WasabiMushyPeas/OPTICAL-FLOW-SENSOR/SLIDE-IMAGES/ofs-board-top.png

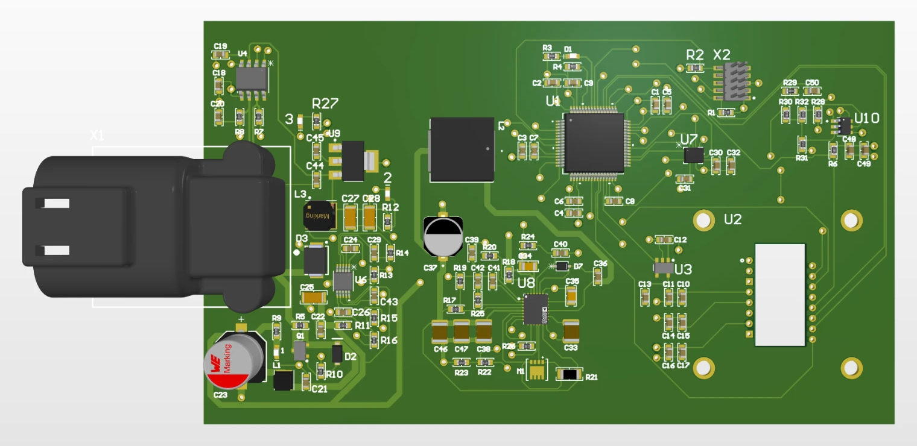
SLIDE-IMAGES/ofs-board-top.png
