WasabiMushyPeas/OPTICAL-FLOW-SENSOR/CAD/04_nine_led_layout_dimensioned.png

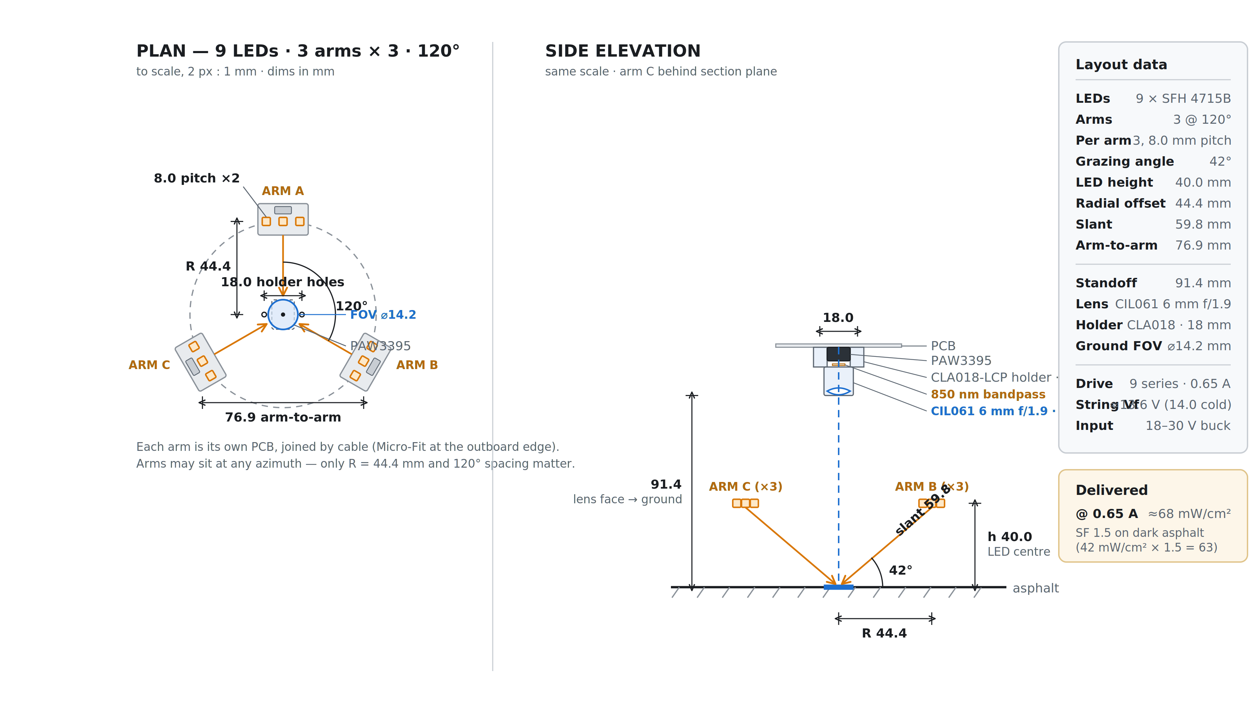
CAD/04_nine_led_layout_dimensioned.png
