WasabiMushyPeas/OPTICAL-FLOW-SENSOR/OFS.drawio.png

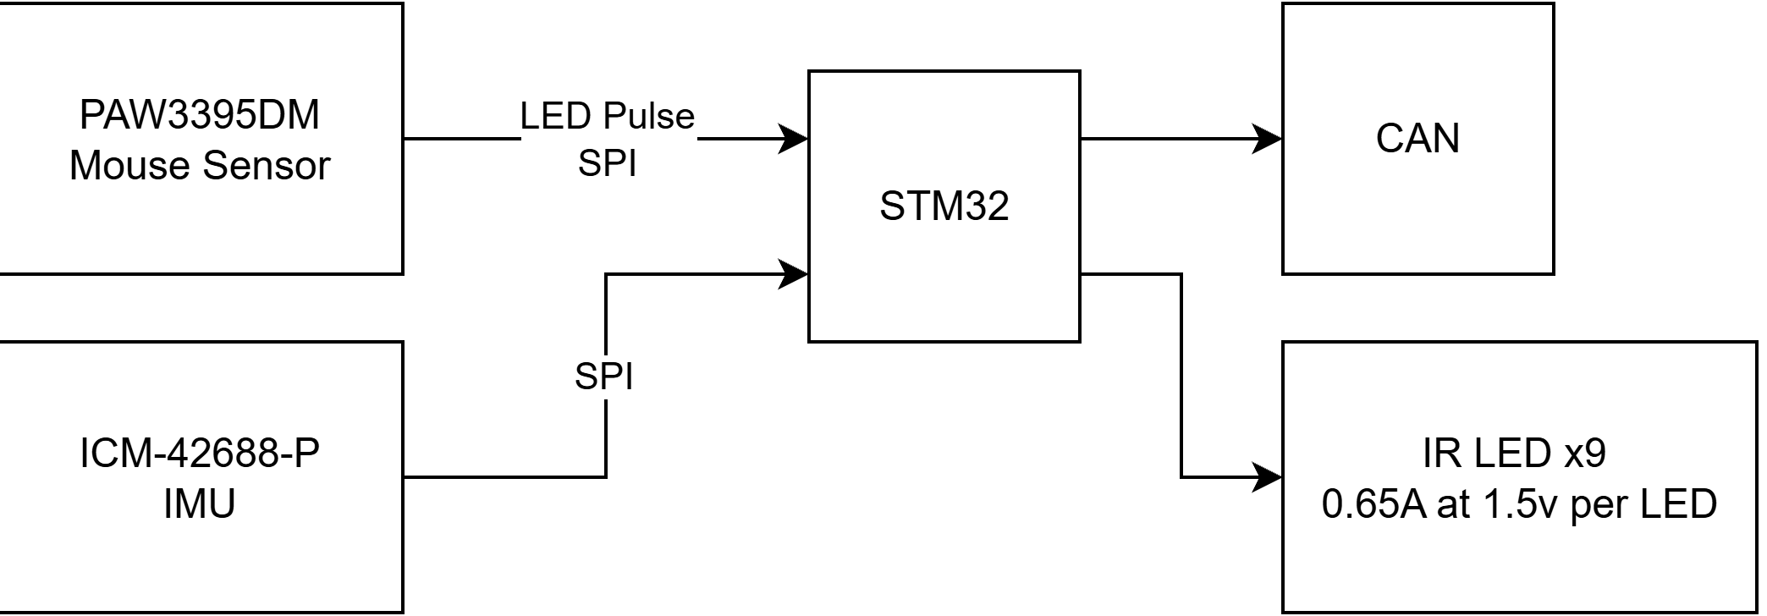
OFS.drawio.png
