WasabiMushyPeas/OPTICAL-FLOW-SENSOR/OFS.png

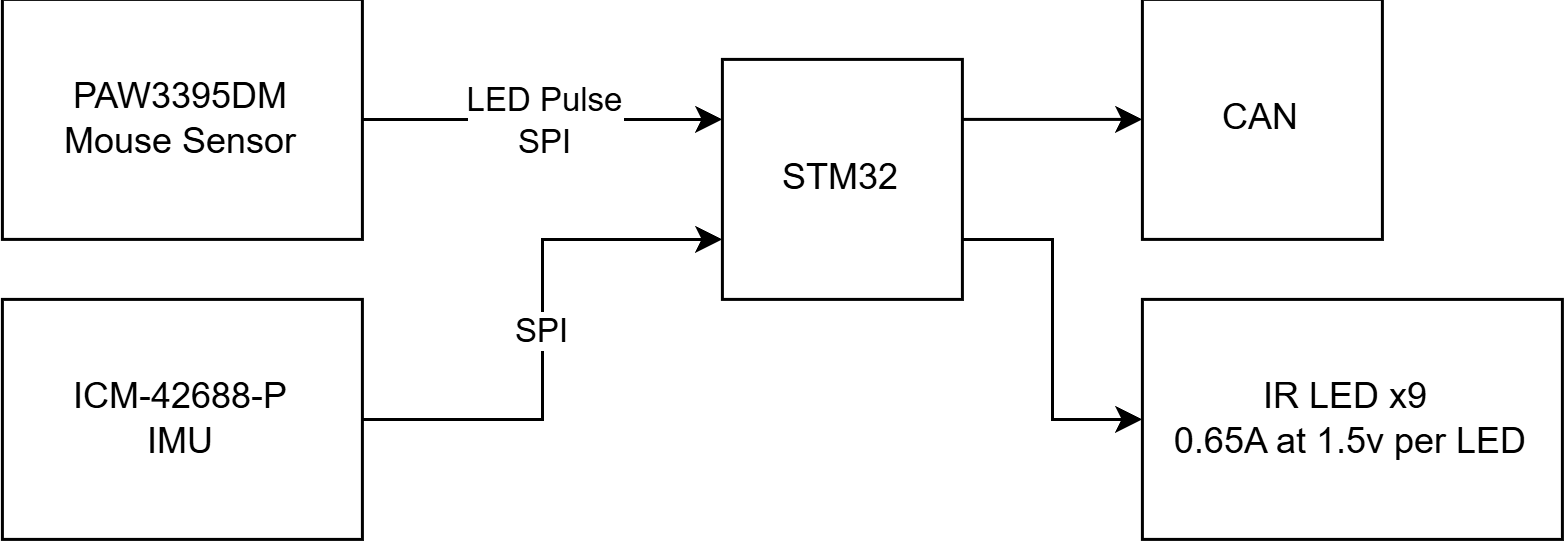
OFS.png
