WasabiMushyPeas/OPTICAL-FLOW-SENSOR/SLIDE-IMAGES/ofs-board-bottom.png

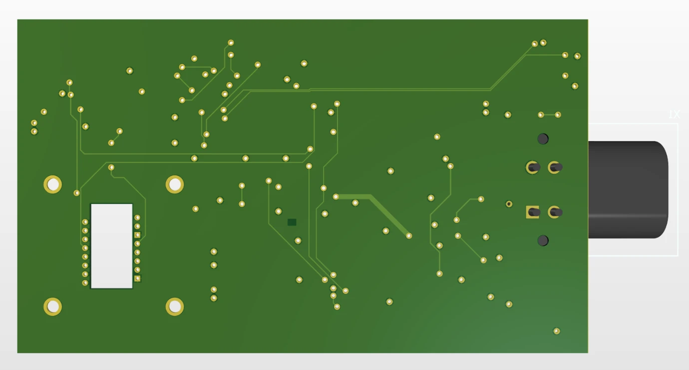
SLIDE-IMAGES/ofs-board-bottom.png
