WasabiMushyPeas/OPTICAL-FLOW-SENSOR/CAD/1-25MM-AP.SLDPRT

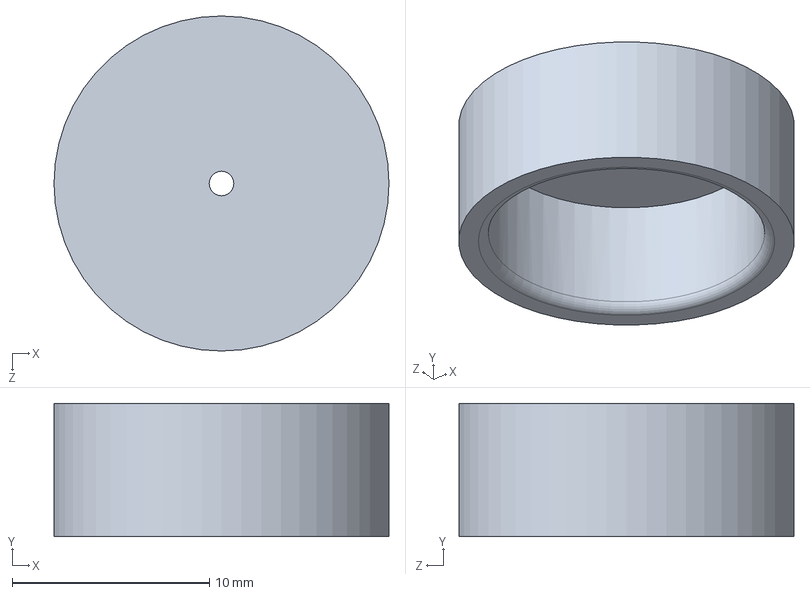
[picture p6: CAD file, 2026-08-03]
CAD/1-25MM-AP.SLDPRT
17.0 x 6.75 x 17.0 mm
