WasabiMushyPeas/OPTICAL-FLOW-SENSOR/CAD/CLA018/CLA018.stp

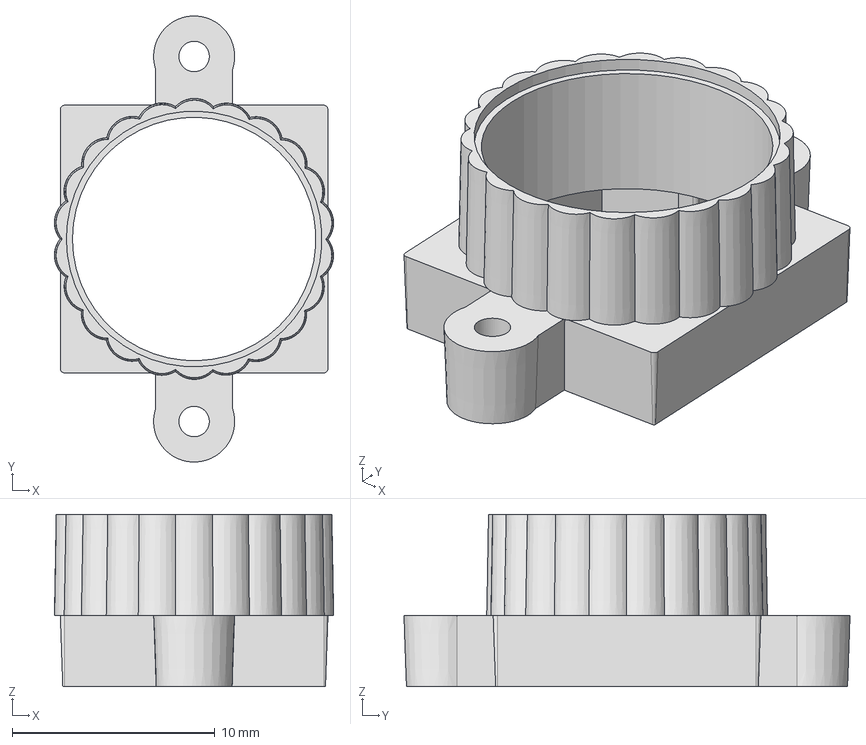
[picture p7: CAD file, 2026-07-28]
CAD/CLA018/CLA018.stp
13.8 x 22.0 x 8.50 mm
