WasabiMushyPeas/OPTICAL-FLOW-SENSOR/CAD/PCBs/OFS-BOARD.SLDPRT

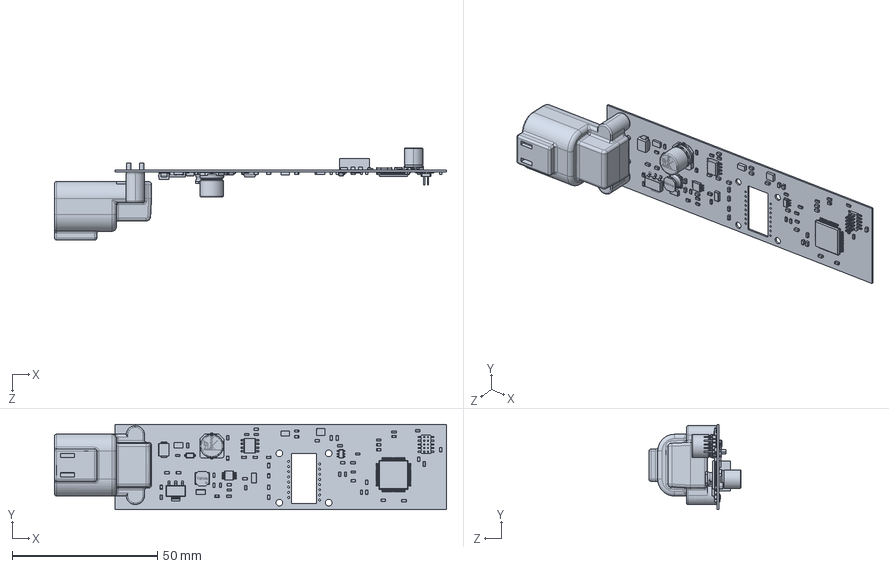
[picture p8: CAD file, 2026-09-30]
CAD/PCBs/OFS-BOARD.SLDPRT
135.1 x 29.4 x 31.9 mm
