WasabiMushyPeas/OPTICAL-FLOW-SENSOR/CAD/LENS-MOUNT.SLDPRT

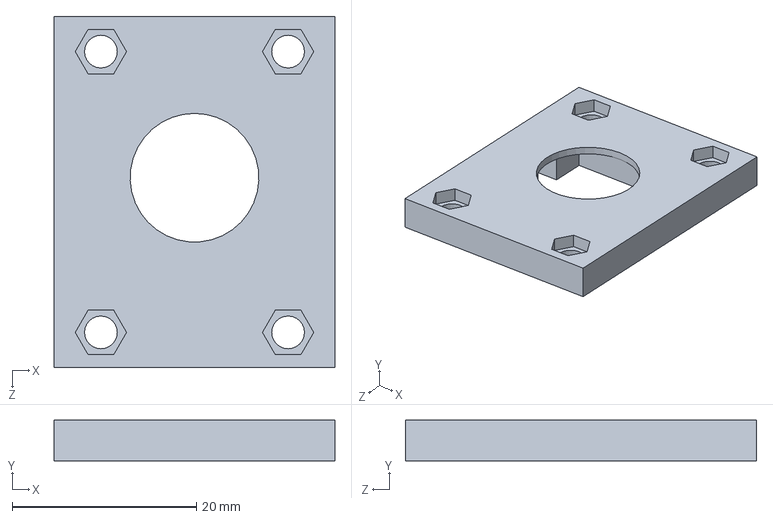
[picture p9: CAD file, 2026-08-03]
CAD/LENS-MOUNT.SLDPRT
30.5 x 4.45 x 38.1 mm
