WasabiMushyPeas/OPTICAL-FLOW-SENSOR/CAD/PCBs/LED-PCB.SLDPRT

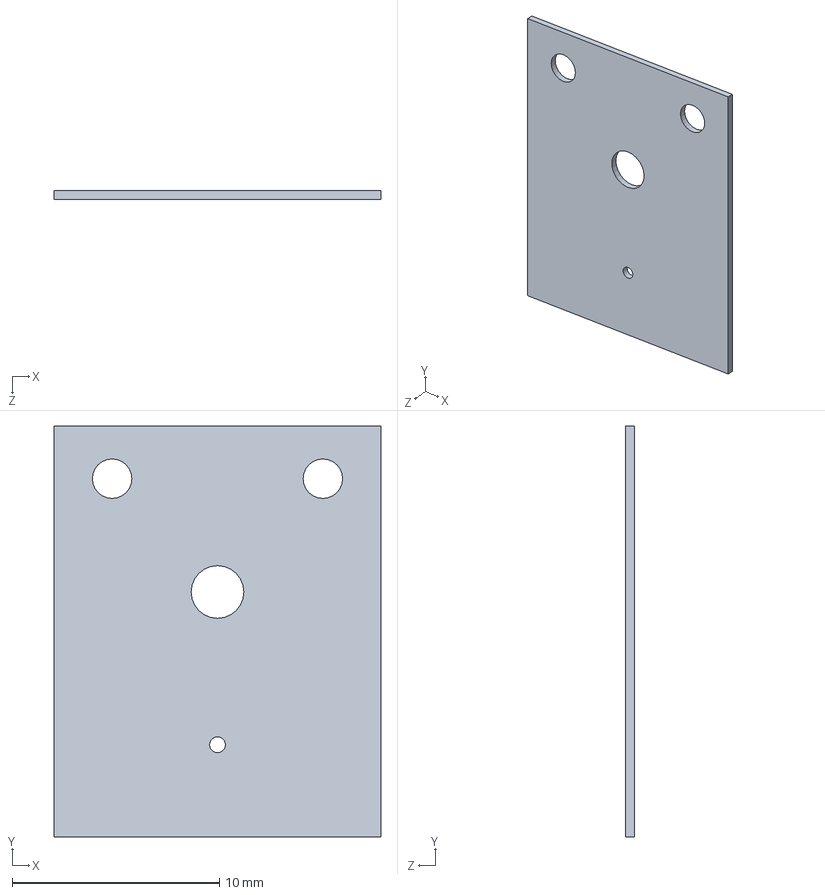
[picture p10: CAD file, 2026-09-09]
CAD/PCBs/LED-PCB.SLDPRT
15.7 x 19.8 x 0.411 mm
