WasabiMushyPeas/OPTICAL-FLOW-SENSOR/CAD/LENS-MOUNT-ALIGN.SLDPRT

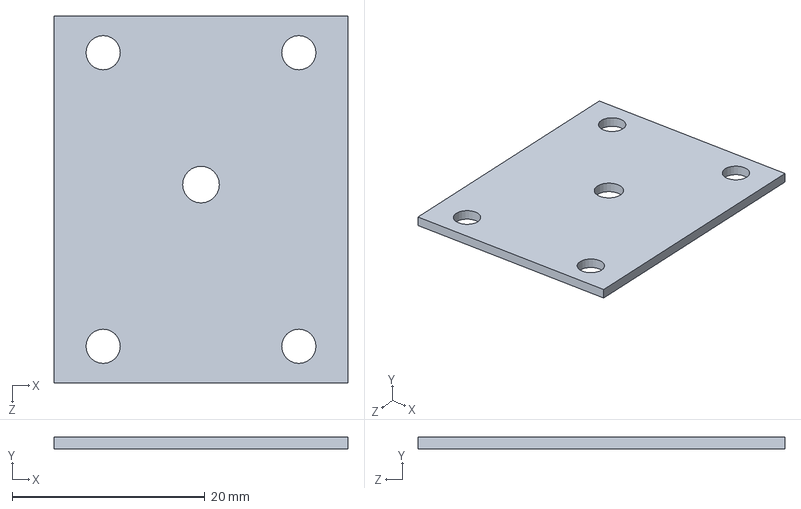
[picture p11: CAD file, 2026-07-28]
CAD/LENS-MOUNT-ALIGN.SLDPRT
30.5 x 1.27 x 38.1 mm
