WasabiMushyPeas/OPTICAL-FLOW-SENSOR/(list of files, cad)

Other CAD files:
CAD/LENS/1-5MM-AP.SLDPRT
CAD/1-25MM-AP.STL
CAD/CLA018/CLA018.SLDASM
CAD/LENS-MOUNT-ALIGN.STL
CAD/LENS-MOUNT.STL
CAD/PCBs/OFS-BOARD.x_t
