WasabiMushyPeas/OPTICAL-FLOW-SENSOR/PCB/OPTICAL-FLOW-PCB-STM32-V2/OPTICAL-FLOW-BOARD.pdf

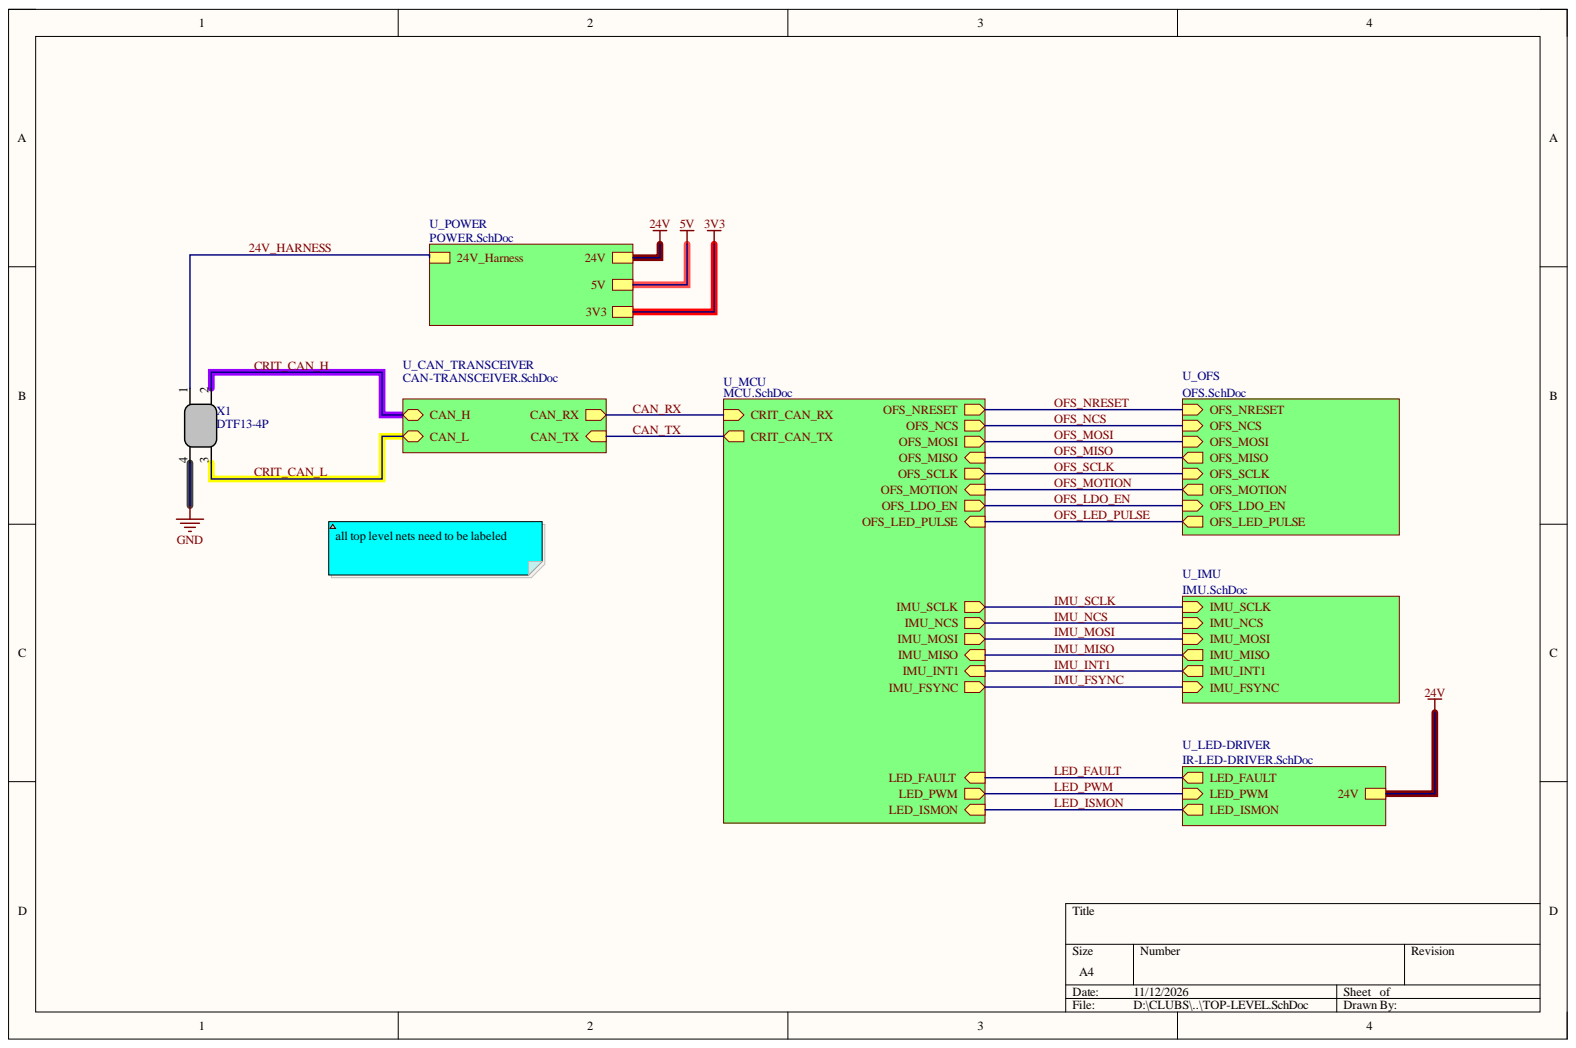
[picture p12: page 1]

all top level nets ne

ed to be labele

Siz e A4 | Numb e r | R evisio n

Da te : 11/12/20 2 6 | She et of
File : D:\CLUB S\. .\TOP -LE V EL . S c hD o c | Dr awn B y :

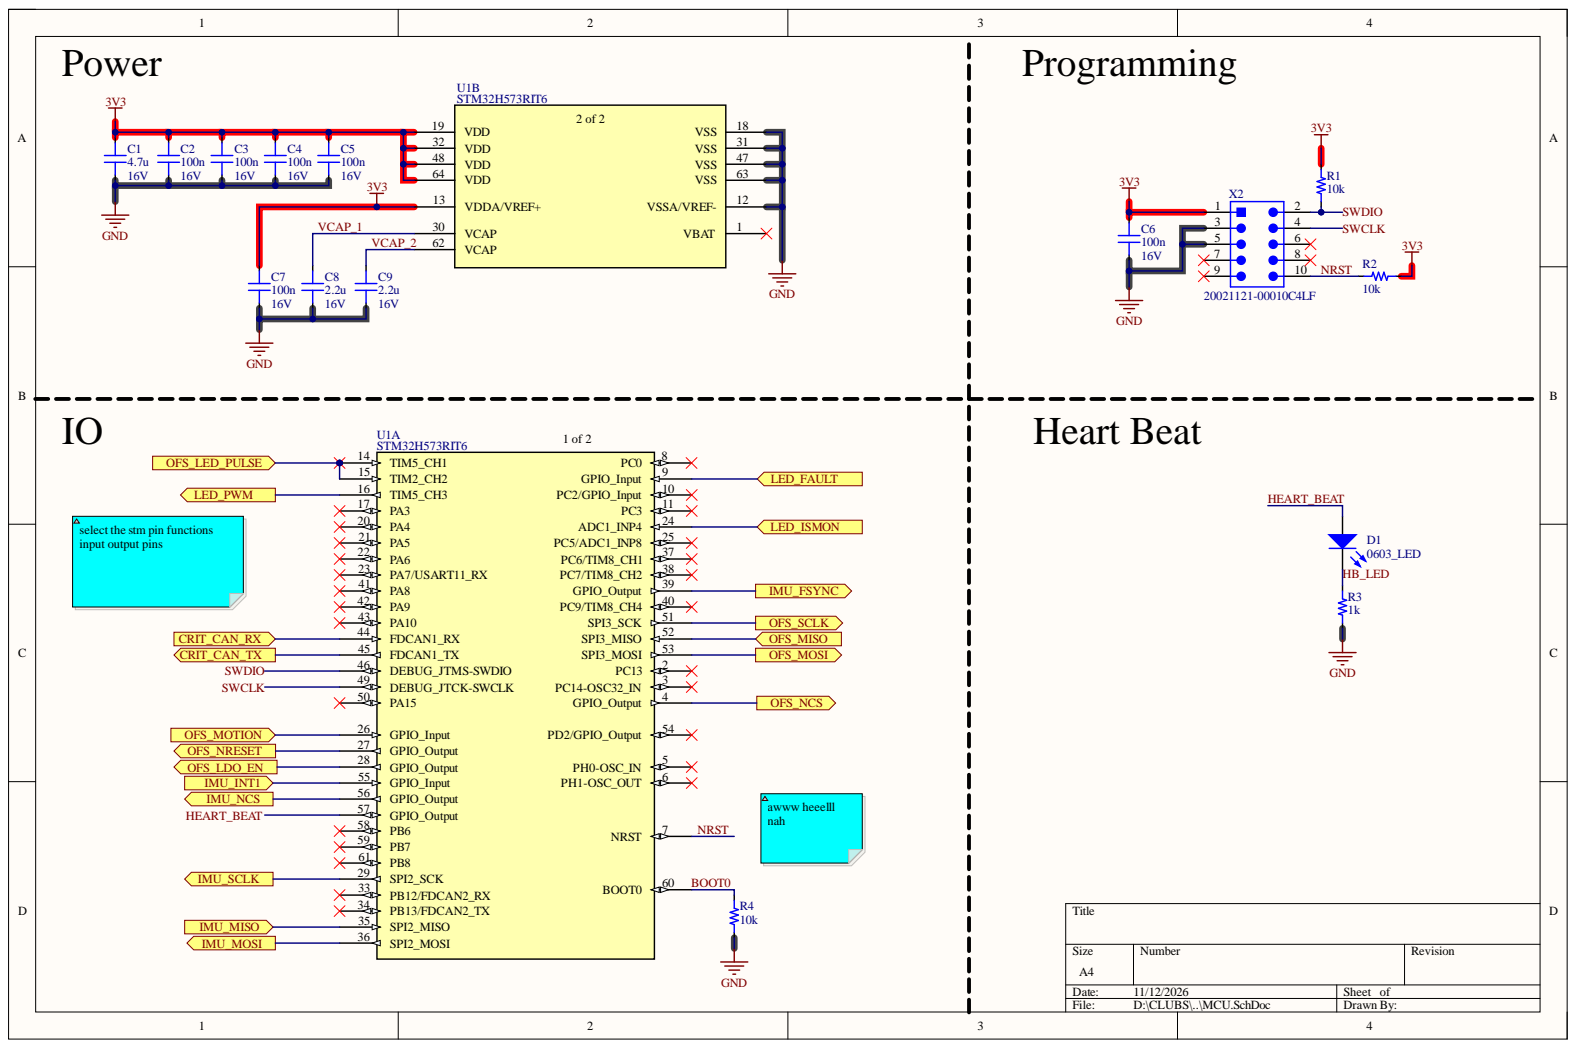
[picture p13: page 2]

VCAP_1 | VCAP 30

VCAP_2 | VCAP 62

select the stm pin functions
input output pins

Size A4 | Number | Revision

Date: 11/12/2026 | Sheet of
File: D:\CLUBS\..\MCU.SchDoc | Drawn By:

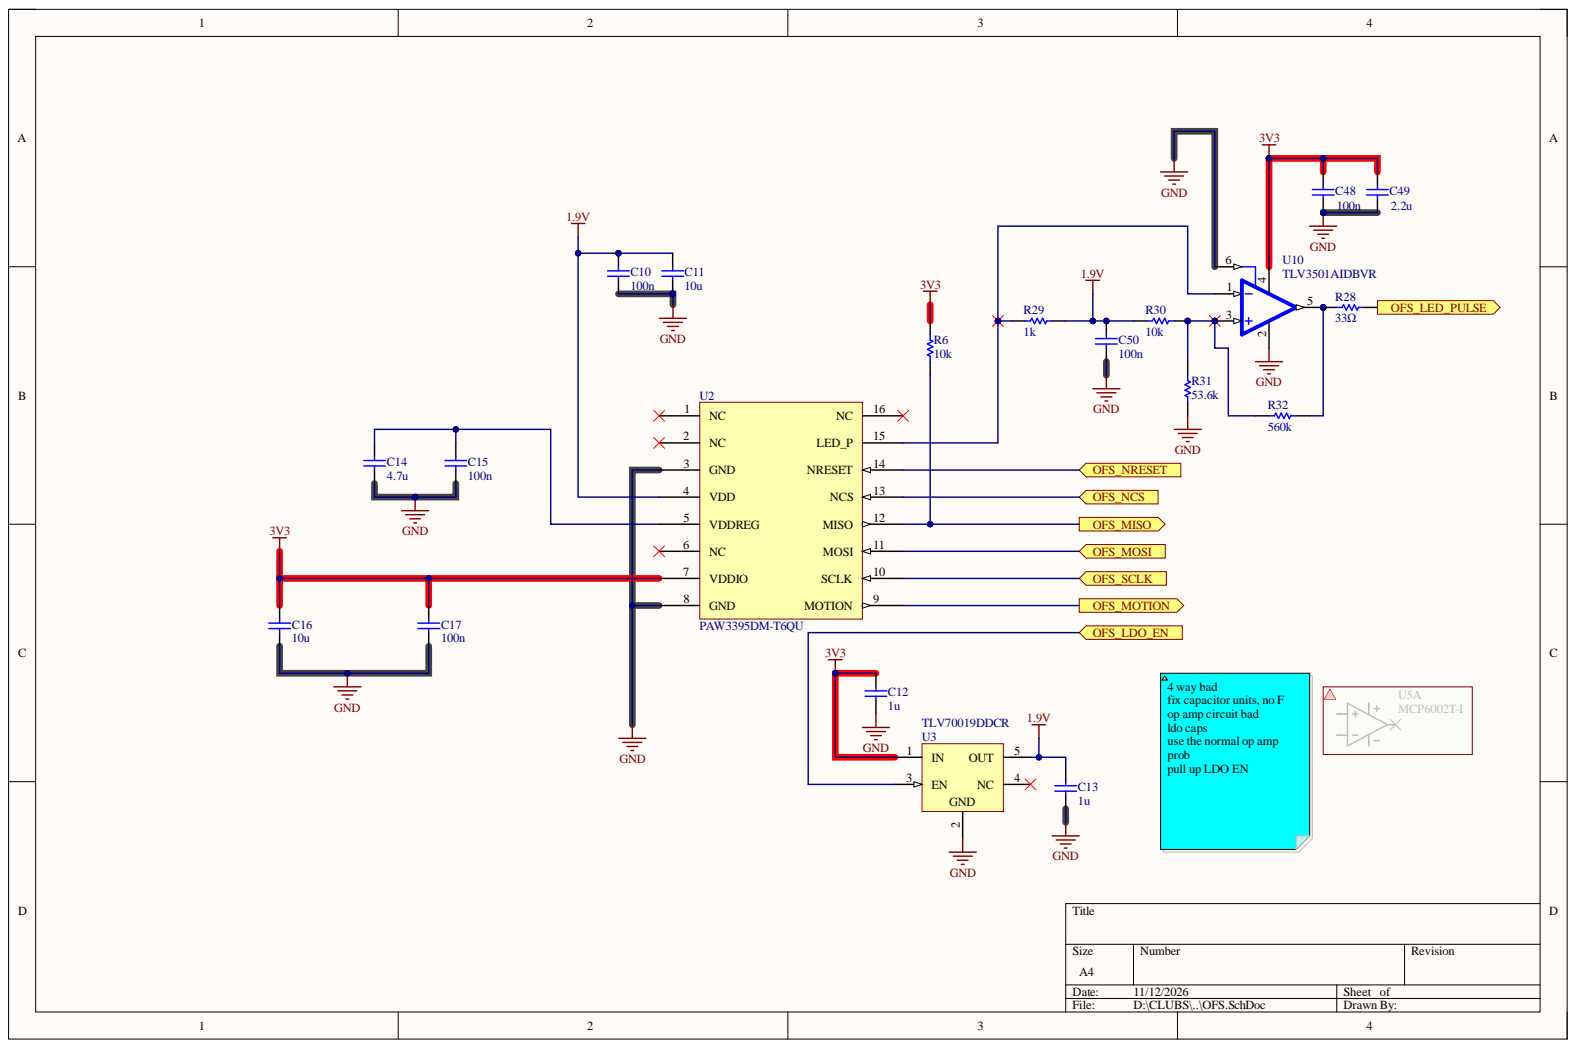
[picture p14: page 3]

4 way ba
fix
ldo
use the normal op
pull up LDO EN

Siz e A4 | Numb e r | R evisio n

Da te : 11/12/20 2 6 | She et of
File : D:\CLUB S\. .\OF S . S c hD o c | Dr awn B y :

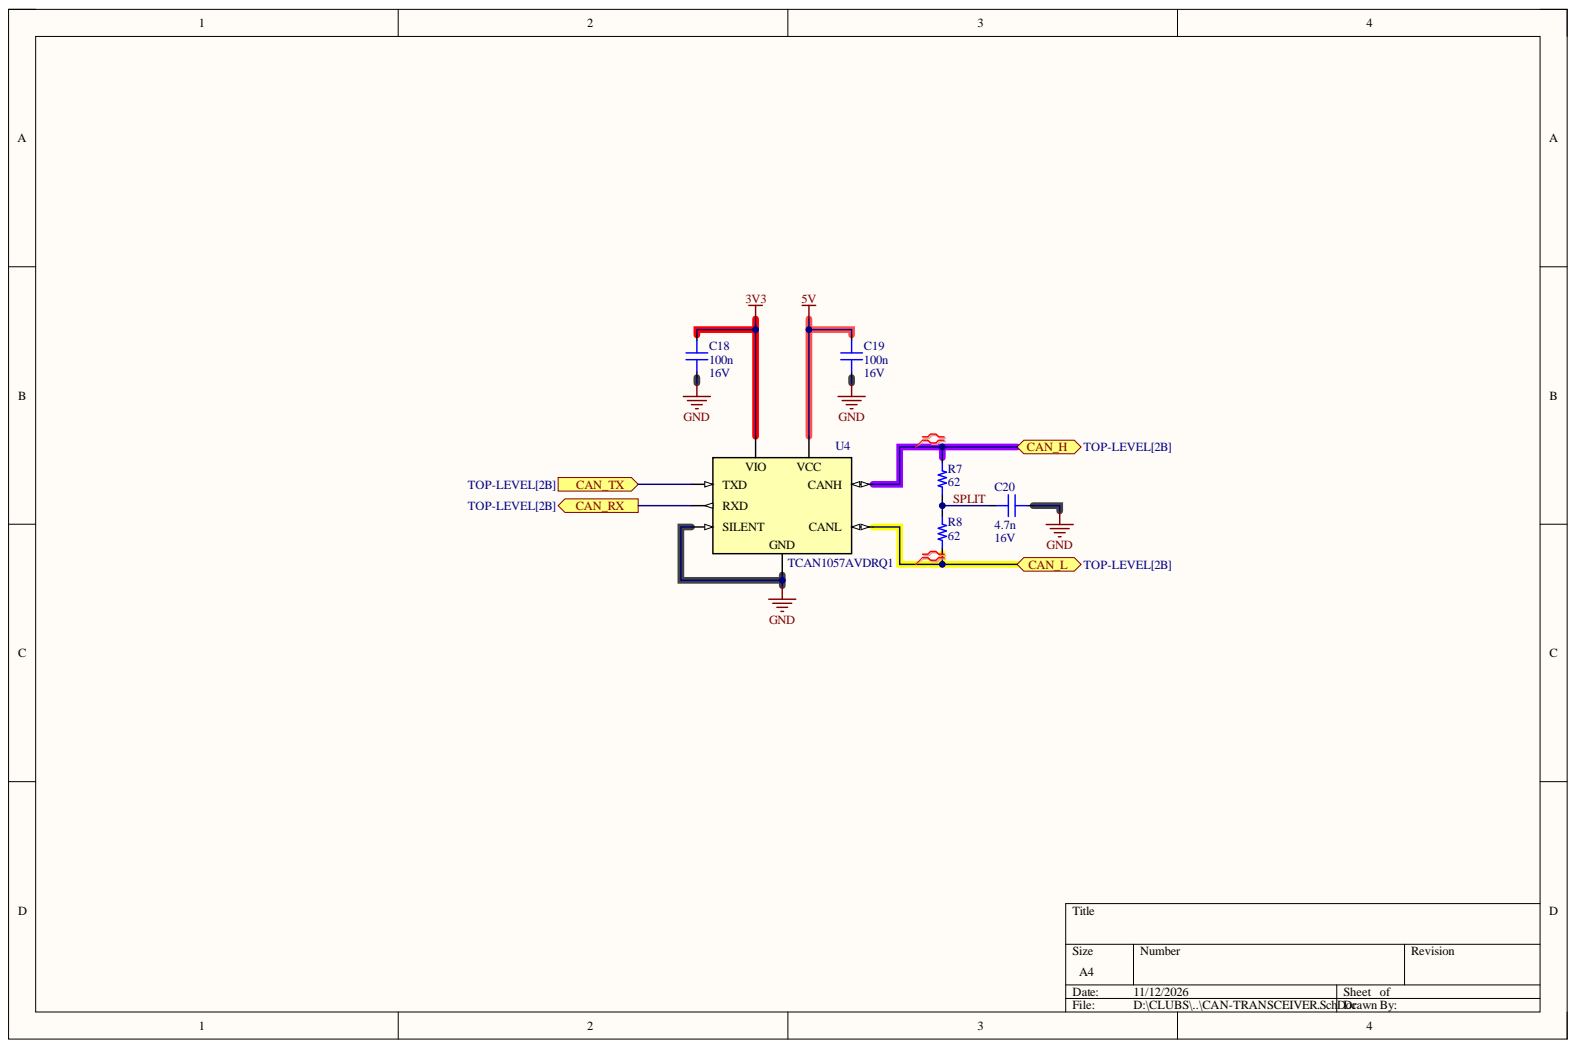
[picture p15: page 4]

Size A4 | Number | Revision

Date: 11/12/2026 | Sheet of
File: D:\CLUBS\..\CAN-TRANSCEIVER.SchDDr ocawn By:

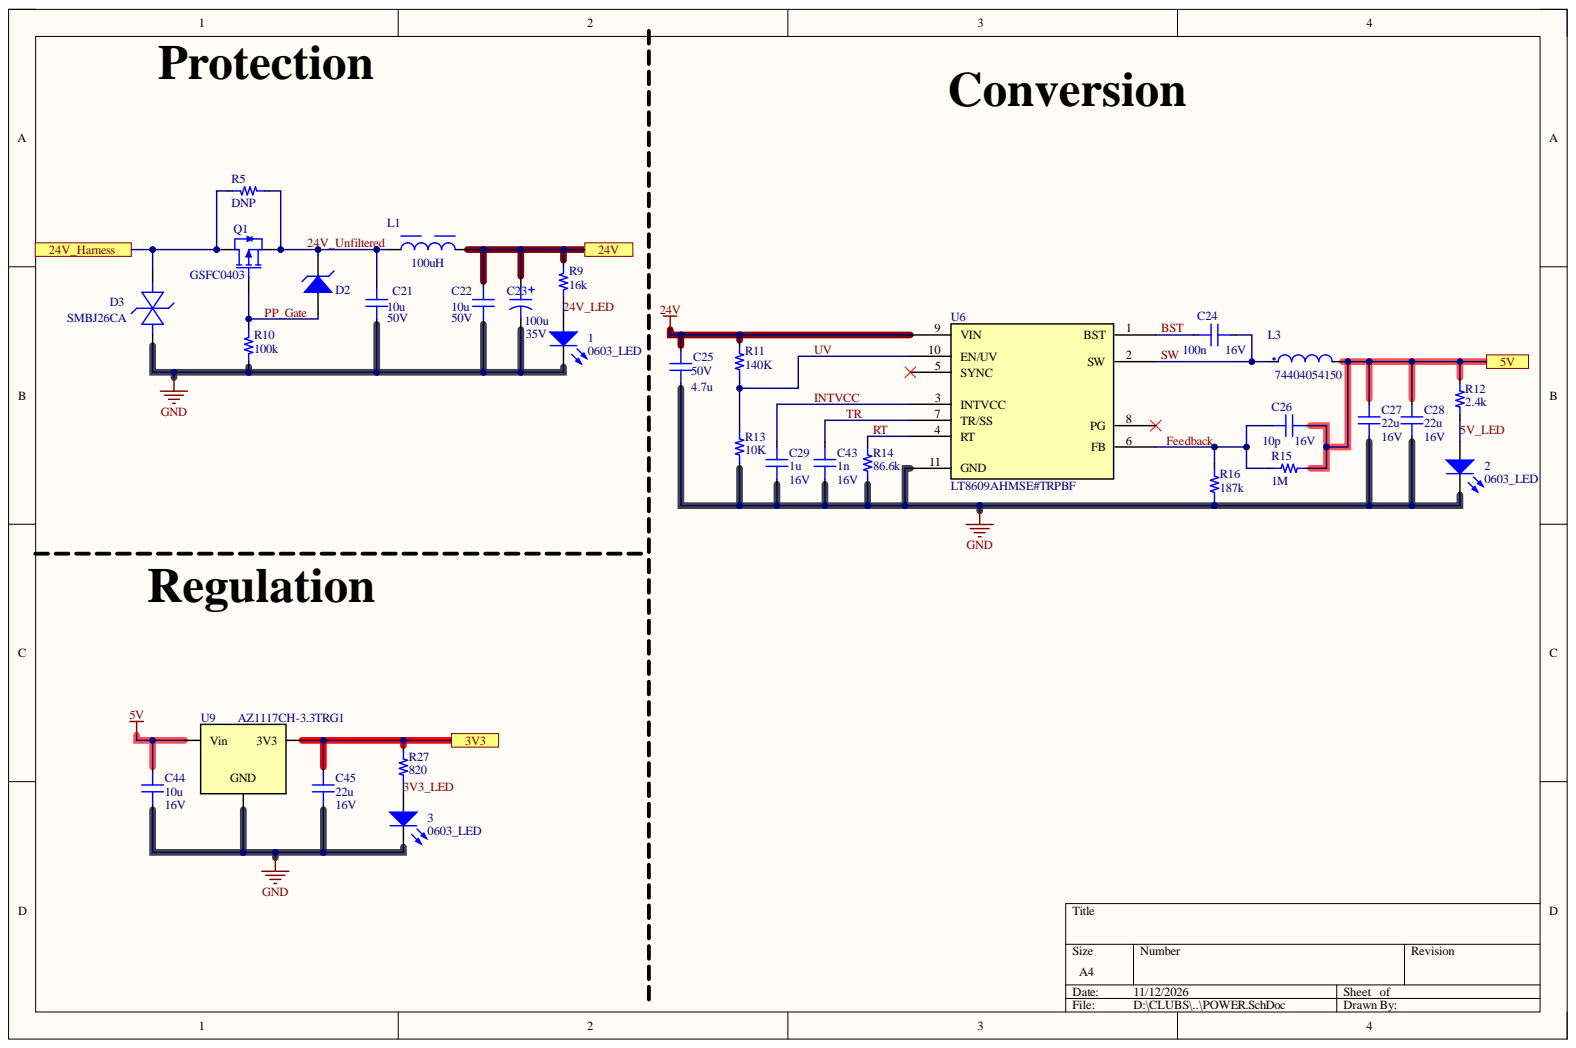
[picture p16: page 5]

Size A4 | Number | Revision

Date: 11/12/2026 | Sheet of
File: D:\CLUBS\..\POWER.SchDoc | Drawn By:

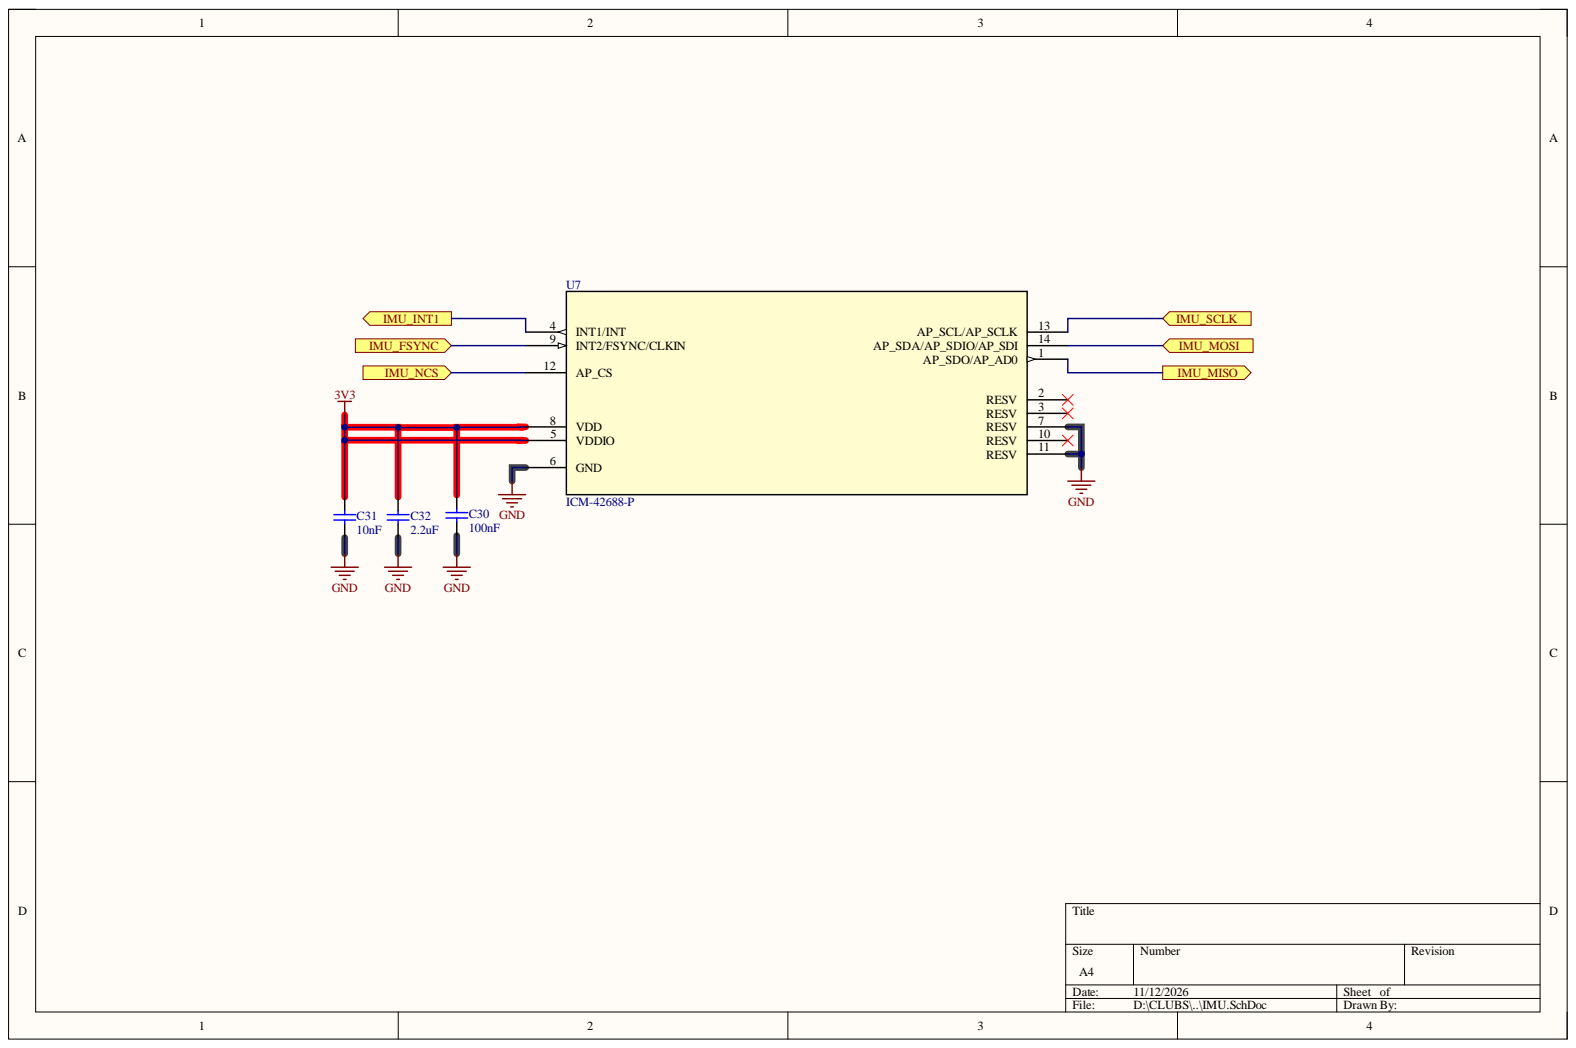
[picture p17: page 6]

Siz e A4 | Numb e r | R evisio n

Da te : 11/12/20 2 6 | She et of
File : D:\CLUB S\. .\IMU. S c hD o c | Dr awn B y :

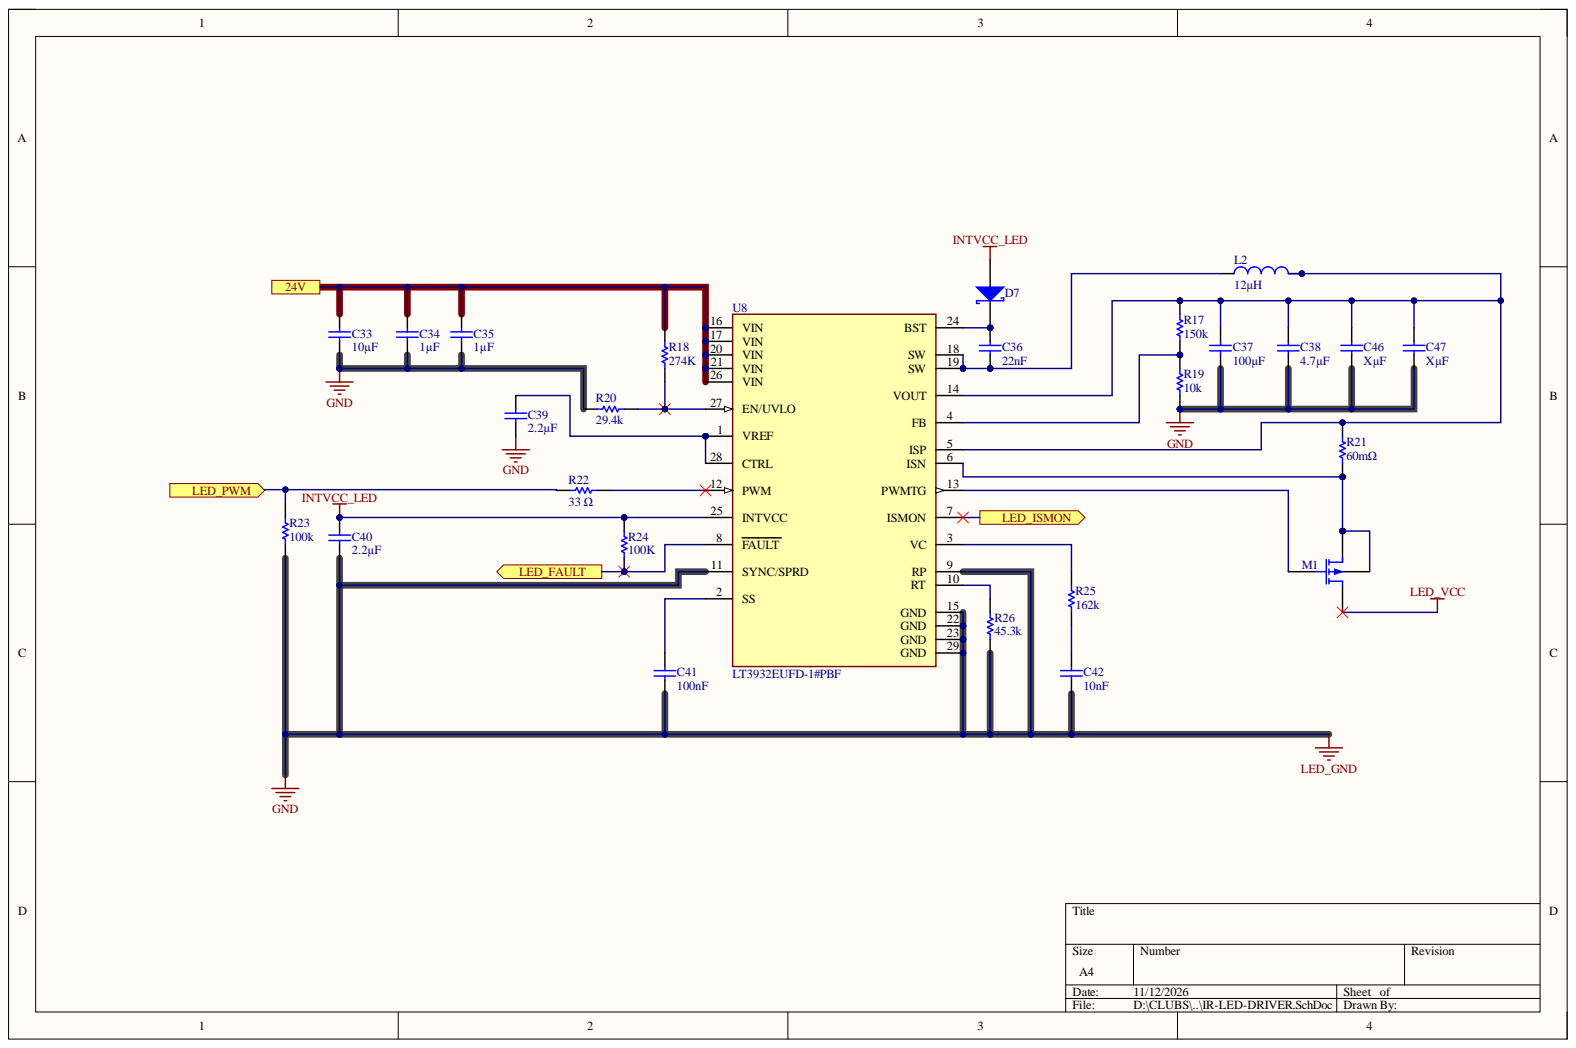
[picture p18: page 7]

Siz e A4 | Numb e r | R evisio n

Da te : 11/12/20 2 6 | She et of
File : D:\CLUB S\. .\I R -LED-DR IVE R . S c hD o c | Dr awn B y :

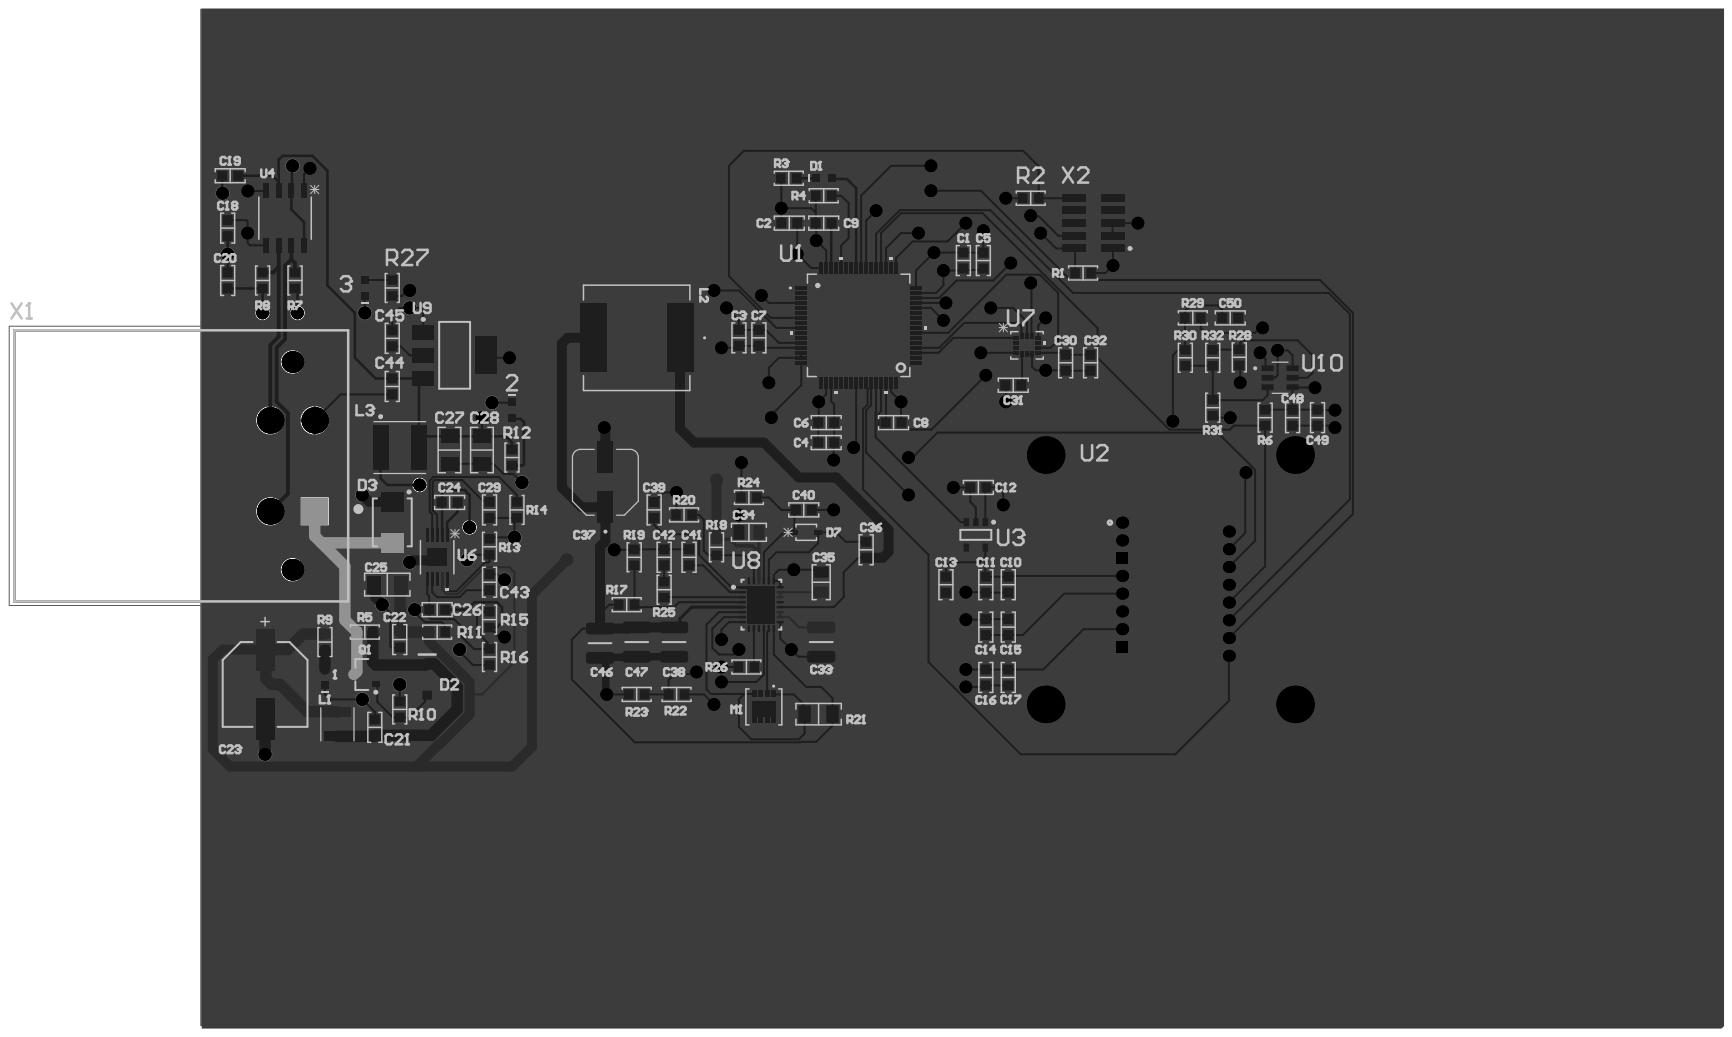
[picture p19: page 8]
