WasabiMushyPeas/OPTICAL-FLOW-SENSOR/CAD/CLA018/CLA018-LCP Lens Holder.pdf

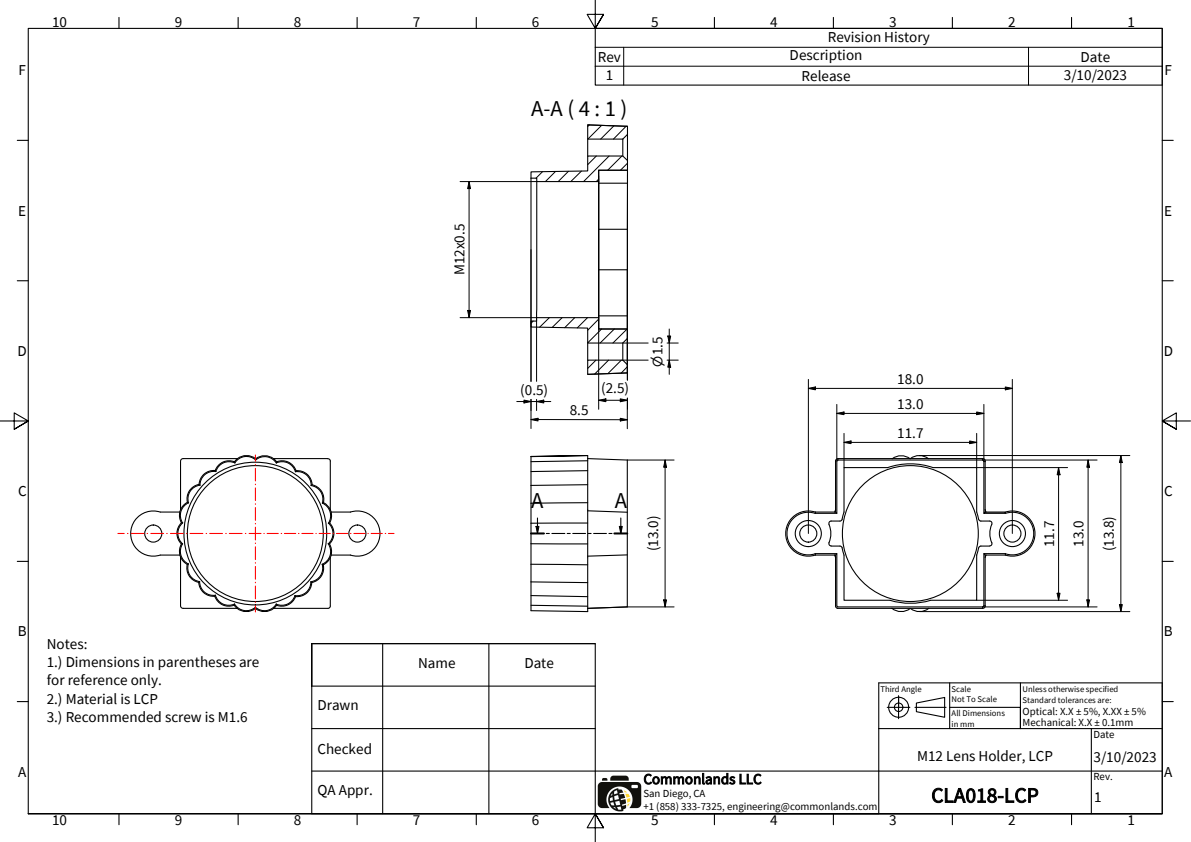
[picture p20: page 1]
M12 Lens Holder, LCP; All Dimensions in mm; QA Appr.

Revision History

Rev | Description | Date
1 | Release | 3/10/2023

Notes:
1.) Dimensions in parentheses are
for reference only.
2.) Material is LCP
3.) Recommended screw is M1.6

Name | Date

Drawn | | | Third Angle | Scale Not To Scale | Unless otherwise specified Standard tolerances are: Optical: X.X ± 5%, X.XX ± 5% Mechanical: X.X ± 0.1mm

Commonlands LLC
San Diego, CA
+1 (858) 333-7325, engineering@commonlands.com
