WasabiMushyPeas/OPTICAL-FLOW-SENSOR/PCB/OPTICAL-FLOW-PCB-STM32-V2/LTSpiceSims/LED-DRIVER.asc

C1: cap; 10µF
C2: cap; 1µF
C3: cap; 1µF
C4: cap; 2.2µF
C5: cap; 2.2µF
C6: cap; 100nF
C7: cap; 10nF
C8: cap; 100µF
C9: cap; 4.7µF
C10: cap; 22nF
D1: diode; SFH4715B
D2: diode; SFH4715B
D3: diode; SFH4715B
D4: diode; SFH4715B
D5: diode; SFH4715B
D6: diode; SFH4715B
D7: diode
L1: ind; 12µH; Rser=1m
M1: pmos; FDS4685
R1: res; 274k
R2: res; 29.4k
R3: res; 33
R4: res; 100k
R5: res; 100k
R6: res; 45.3k
R7: res; 162k
R8: res; 60m
R9: res; 10k
R10: res; 220k
U1: LT3932-1
V1: voltage; 24v
Named nets: 0, LED_PWM, LED_FAULT, INTVcc, LED_ISMON, LED_VCC
.model SFH4715B D(Is=1e-18 N=2.5 Rs=0.25 Cjo=50p Iave=2 Vpk=5 type=LED)
Vp p 0 PULSE(0 3.3 0 10n 10n 3u 1m)
B1 LED_PWM 0 V=if(time<10m, 3.3, V(p))
.tran 0 15m 0 5n startup
