WasabiMushyPeas/OPTICAL-FLOW-SENSOR/(list of files, drawings)

Other design files:
PCB/LED-PCB/CUSTOM-COMPONENTS/OSRAM_SFH4715B_Altium_Library_v3/Imported OSRAM_SFH4715B_Altium_Import_v3.Library.PrjPcb/OSRAM_SFH4715B_Altium_Import_v3.Library.PrjPcb
PCB/LED-PCB/CUSTOM-COMPONENTS/OSRAM_SFH4715B_Altium_Library_v3/Imported OSRAM_SFH4715B_Altium_Import_v3.Library.PrjPcb/OSRAM_SFH4715B_Altium_Import_v3.PCBLIB
PCB/LED-PCB/CUSTOM-COMPONENTS/OSRAM_SFH4715B_Altium_Library_v3/Imported OSRAM_SFH4715B_Altium_Import_v3.Library.PrjPcb/OSRAM_SFH4715B_Altium_Import_v3.SCHLIB
PCB/LED-PCB/LED-PCB.PcbDoc
PCB/LED-PCB/LED-PCB.PrjPcb
PCB/LED-PCB/LED-PCB.SchDoc
PCB/OPTICAL-FLOW-PCB-STM32-V2/CAN-TRANSCEIVER.SchDoc
PCB/OPTICAL-FLOW-PCB-STM32-V2/IMU.SchDoc
PCB/OPTICAL-FLOW-PCB-STM32-V2/IR-LED-DRIVER.SchDoc
PCB/OPTICAL-FLOW-PCB-STM32-V2/MCU.SchDoc
PCB/OPTICAL-FLOW-PCB-STM32-V2/OFS-BOARD.PcbDoc
PCB/OPTICAL-FLOW-PCB-STM32-V2/OFS.SchDoc
PCB/OPTICAL-FLOW-PCB-STM32-V2/OPTICAL-FLOW-BOARD.PrjPcb
PCB/OPTICAL-FLOW-PCB-STM32-V2/POWER.SchDoc
PCB/OPTICAL-FLOW-PCB-STM32-V2/TOP-LEVEL.SchDoc
PCB/OPTICAL-FLOW-PCB-STM32/OPTICAL-FLOW-STM32/CAN_TRANSCEIVER.SchDoc
PCB/OPTICAL-FLOW-PCB-STM32/OPTICAL-FLOW-STM32/CONNECTOR.SchDoc
PCB/OPTICAL-FLOW-PCB-STM32/OPTICAL-FLOW-STM32/IMU.SchDoc
PCB/OPTICAL-FLOW-PCB-STM32/OPTICAL-FLOW-STM32/LED-DRIVER.SchDoc
PCB/OPTICAL-FLOW-PCB-STM32/OPTICAL-FLOW-STM32/MCU.SchDoc
PCB/OPTICAL-FLOW-PCB-STM32/OPTICAL-FLOW-STM32/OFS.SchDoc
PCB/OPTICAL-FLOW-PCB-STM32/OPTICAL-FLOW-STM32/OFS_2027.PcbDoc
PCB/OPTICAL-FLOW-PCB-STM32/OPTICAL-FLOW-STM32/OPTICAL-FLOW-STM32.PrjPcb
PCB/OPTICAL-FLOW-PCB-STM32/OPTICAL-FLOW-STM32/POWER.SchDoc
PCB/OPTICAL-FLOW-PCB-STM32/OPTICAL-FLOW-STM32/TOP_LEVEL.SchDoc
PCB/OPTICAL-FLOW-PCB/CUSTOM-COMPONENTS/436500200/436500200/436500200.SchLib
PCB/OPTICAL-FLOW-PCB/CUSTOM-COMPONENTS/436500200/436500200/CONN_SD-43650-001_02_MOL.PcbLib
PCB/OPTICAL-FLOW-PCB/CUSTOM-COMPONENTS/Imported PAW3395/KiCad.PcbLib
PCB/OPTICAL-FLOW-PCB/CUSTOM-COMPONENTS/Imported PAW3395/PAW3395.PrjPcb
PCB/OPTICAL-FLOW-PCB/CUSTOM-COMPONENTS/PAW3395DM-T6QU.PcbLib
PCB/OPTICAL-FLOW-PCB/CUSTOM-COMPONENTS/PAW3395DM-T6QU.SchLib
PCB/OPTICAL-FLOW-PCB/DEMO-BOARD.PcbDoc
PCB/OPTICAL-FLOW-PCB/DEMO-BOARD.SchDoc
PCB/OPTICAL-FLOW-PCB/OPTICAL-FLOW-PCB.PrjPcb
