WasabiMushyPeas/OPTICAL-FLOW-SENSOR/STM32-OF/Core/Src/main.c

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
/* Includes ------------------------------------------------------------------*/
#include "main.h"

/* USER CODE BEGIN Includes */

#include "paw3395.h"
#include <stdio.h>
#include <string.h>

/* USER CODE END Includes */

SPI_HandleTypeDef hspi1;

UART_HandleTypeDef huart2;

/* USER CODE BEGIN PV */

char msg[192];

#define PAW3395_TEST_USE_BURST  1U

#define UART_PRINT(...) do {                                                \
    int _n = snprintf(msg, sizeof(msg), __VA_ARGS__);                       \
    if (_n > 0) {                                                           \
        uint16_t _len = (uint16_t)((_n < (int)sizeof(msg))                  \
                         ? _n : ((int)sizeof(msg) - 1));                    \
        HAL_UART_Transmit(&huart2, (uint8_t *)msg, _len, 100);              \
    }                                                                       \
} while (0)

/* USER CODE END PV */

void SystemClock_Config(void);
static void MX_GPIO_Init(void);
static void MX_SPI1_Init(void);
static void MX_USART2_UART_Init(void);
/**
  * @brief  The application entry point.
  * @retval int
  */
int main(void)
{

  /* MCU Configuration--------------------------------------------------------*/

  /* Reset of all peripherals, Initializes the Flash interface and the Systick. */
  HAL_Init();

  /* Configure the system clock */
  SystemClock_Config();

  /* Initialize all configured peripherals */
  MX_GPIO_Init();
  MX_SPI1_Init();
  MX_USART2_UART_Init();
  /* USER CODE BEGIN 2 */

  DWT_Delay_Init();

  /* Power up the sensor's 1.9 V rail (LDO enable — VERIFY active-high) */
  HAL_GPIO_WritePin(LDO_EN_GPIO_Port, LDO_EN_Pin, GPIO_PIN_SET);
  HAL_Delay(50);                       /* let the rail settle */

  /* Bring NRESET out of reset (active low -> drive high for normal run) */
  HAL_GPIO_WritePin(NRESET_GPIO_Port, NRESET_Pin, GPIO_PIN_RESET);
  HAL_Delay(10);
  HAL_GPIO_WritePin(NRESET_GPIO_Port, NRESET_Pin, GPIO_PIN_SET);
  HAL_Delay(50);

  UART_PRINT("\r\n--- PAW3395 bring-up ---\r\n");

  if ((hspi1.Init.DataSize != SPI_DATASIZE_8BIT) ||
      (hspi1.Init.Direction != SPI_DIRECTION_2LINES) ||
      (hspi1.Init.CLKPolarity != SPI_POLARITY_HIGH) ||
      (hspi1.Init.CLKPhase != SPI_PHASE_2EDGE))
  {
      UART_PRINT("ERROR: SPI1 must be 8-bit, 2-line, Mode 3\r\n");
      Error_Handler();
  }

  UART_PRINT("SPI1 PCLK2=%lu Hz, SCLK=%lu Hz\r\n",
             (unsigned long)HAL_RCC_GetPCLK2Freq(),
             (unsigned long)(HAL_RCC_GetPCLK2Freq() / 32U));

  uint8_t id = paw3395_init();
  uint8_t inverse_id = paw3395_read_reg(PAW_REG_INVERSE_ID);

  UART_PRINT("Product ID=0x%02X inverse=0x%02X poll=0x%02X attempts=%u\r\n",
             id,
             inverse_id,
             paw3395_get_init_poll_value(),
             paw3395_get_init_poll_attempts());

  if (id != PAW_PRODUCT_ID_EXPECTED)
  {
      UART_PRINT("ERROR: expected Product ID 0x%02X\r\n",
                 PAW_PRODUCT_ID_EXPECTED);
  }

#if PAW3395_TEST_USE_BURST
  UART_PRINT("Motion test mode: BURST\r\n");
#else
  UART_PRINT("Motion test mode: INDIVIDUAL REGISTERS\r\n");
#endif

  /* USER CODE END 2 */

  /* Infinite loop */
  /* USER CODE BEGIN WHILE */
  while (1)
  {
      /* USER CODE END WHILE */

      /* USER CODE BEGIN 3 */

      paw3395_motion_t sample;

      if (paw3395_read_motion_data(&sample) == HAL_OK)
      {
          GPIO_PinState motion_pin =
              HAL_GPIO_ReadPin(MOTION_GPIO_Port, MOTION_Pin);

          /*
           * Print only when:
           * - the sensor's motion bit is set,
           * - the physical MOTION pin is active-low,
           * - or either delta is nonzero.
           */
//          if (((sample.motion & 0x80U) != 0U) ||
//              (motion_pin == GPIO_PIN_RESET) ||
//              (sample.dx != 0) ||
//              (sample.dy != 0))
//          {
          UART_PRINT("M=%02X PIN=%u X=%6d Y=%6d SQ=%3u SHUT=%5u RAW[%3u..%3u] SUM=%3u\r\n",
                     sample.motion, (unsigned int)motion_pin, sample.dx, sample.dy,
                     sample.squal, sample.shutter, sample.min_raw, sample.max_raw,
                     sample.raw_sum);
          //}
      }
      else
      {
          UART_PRINT("SPI motion-read error\r\n");
      }

      HAL_Delay(30);
  }

  /* USER CODE END 3 */
}

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
