WasabiMushyPeas/OPTICAL-FLOW-SENSOR/STM32-CODE-OFS/Core/Inc/main.h

#define B1_Pin GPIO_PIN_13
#define B1_GPIO_Port GPIOC
#define USART_TX_Pin GPIO_PIN_2
#define USART_TX_GPIO_Port GPIOA
#define USART_RX_Pin GPIO_PIN_3
#define USART_RX_GPIO_Port GPIOA
#define MOTION_Pin GPIO_PIN_8
#define MOTION_GPIO_Port GPIOA
#define NRESET_Pin GPIO_PIN_9
#define NRESET_GPIO_Port GPIOA
#define TMS_Pin GPIO_PIN_13
#define TMS_GPIO_Port GPIOA
#define TCK_Pin GPIO_PIN_14
#define TCK_GPIO_Port GPIOA
#define SWO_Pin GPIO_PIN_3
#define SWO_GPIO_Port GPIOB
#define LDO_EN_Pin GPIO_PIN_5
#define LDO_EN_GPIO_Port GPIOB
#define NCS_Pin GPIO_PIN_6
#define NCS_GPIO_Port GPIOB
