WasabiMushyPeas/OPTICAL-FLOW-SENSOR/(commit log)

2026-07-21 Added PCB
2026-07-23 Improved PCB and lens mount started
2026-07-28 updated cad
2026-07-30 Updated board and CAD
2026-09-07 Added some LED stuff
2026-09-09 Made little single LED module
2026-09-21 Started PCB layout
2026-09-23 Added LED DRIVER
2026-09-30 CAD update
2026-10-06 schematic review 1
2026-10-28 Schematic final review
2026-10-29 Save schematic work before merging club changes
